Ambient-Node/Ambient-Node-HW/before-soldering(plan).JPG

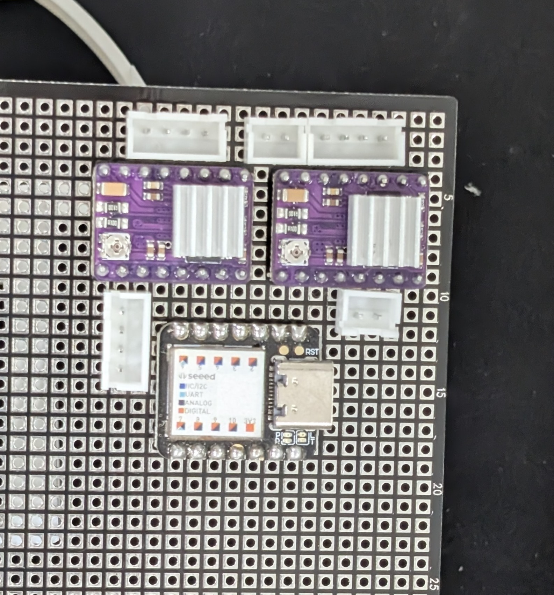
before-soldering(plan).JPG
