Ambient-Node/Ambient-Node-HW/media/soldering-plan.jpg

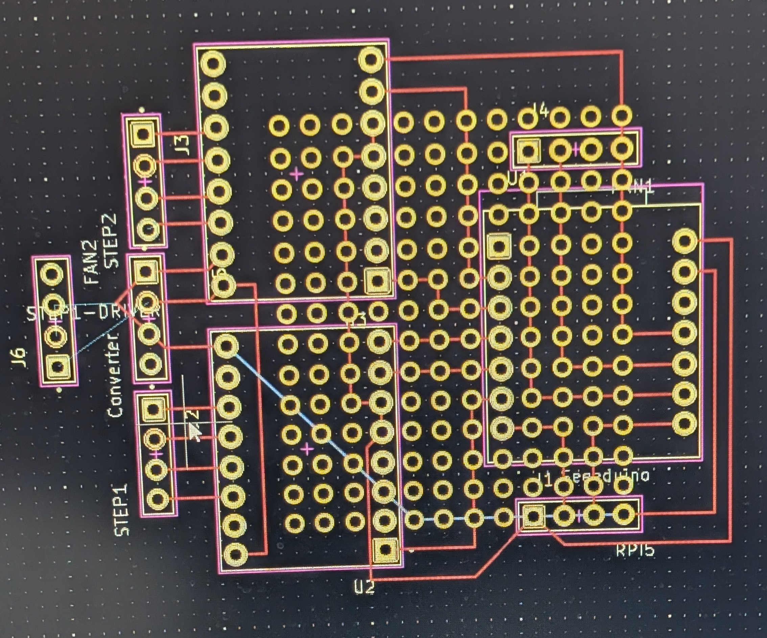
media/soldering-plan.jpg
