Ambient-Node/Ambient-Node-HW/internal-configuration.png

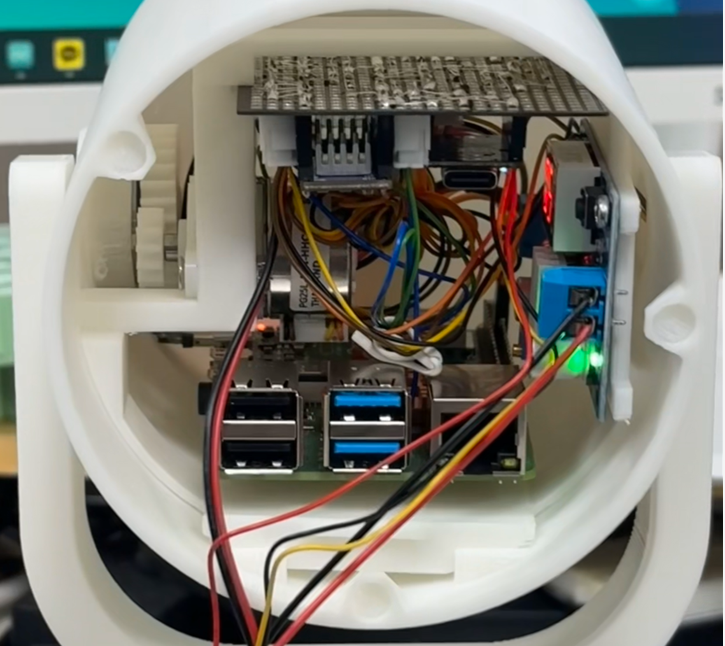
internal-configuration.png
