Ambient-Node/Ambient-Node-HW/media/after-soldering.jpg

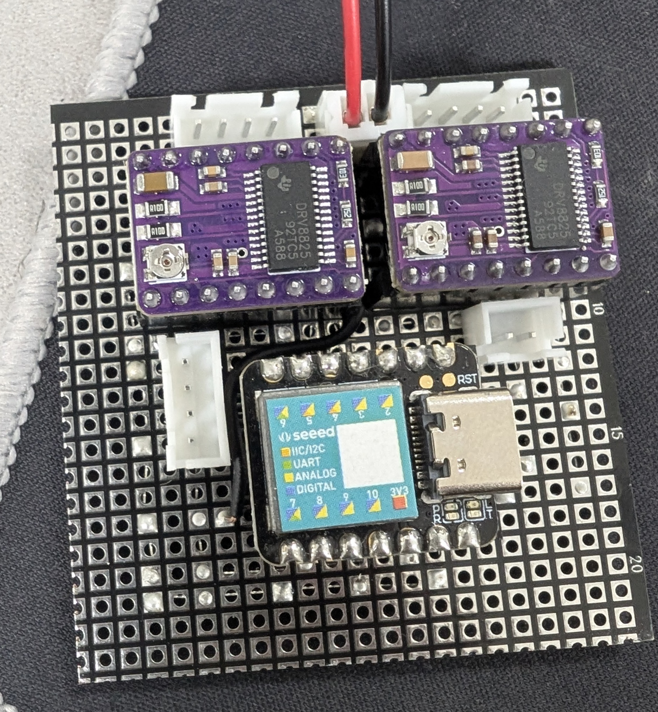
media/after-soldering.jpg
