Ambient-Node/Ambient-Node-HW/codes/PI_test_code/motor_data.csv

Time_ms | Target_Pos | Current_Pos
884507 | -379 | -397
884517 | -379 | -394
884527 | -379 | -394
884537 | -379 | -394
884547 | -379 | -394
884557 | -379 | -394
884567 | -379 | -394
884577 | -379 | -394
884587 | -379 | -394
884597 | -379 | -394
884607 | -379 | -394
884617 | -379 | -394
884627 | -379 | -394
884637 | -379 | -394
884647 | -379 | -394
884657 | -379 | -394
884667 | -379 | -394
884677 | -375 | -391
884687 | -375 | -390
884697 | -375 | -390
884707 | -375 | -390
884717 | -375 | -390
884727 | -375 | -390
884737 | -375 | -390
884747 | -375 | -390
884757 | -375 | -390
884767 | -375 | -390
884777 | -375 | -390
884787 | -375 | -390
884797 | -375 | -390
884807 | -375 | -390
884817 | -375 | -390
884827 | -375 | -390
884837 | -375 | -390
884847 | -375 | -390
884857 | -375 | -390
884867 | -375 | -390
884877 | -375 | -390
884887 | -375 | -390
884897 | -375 | -390
884907 | -375 | -390
884917 | -375 | -390
884927 | -375 | -390
884937 | -375 | -390
884947 | -375 | -390
884957 | -375 | -390
884967 | -375 | -390
884977 | -375 | -390
884987 | -375 | -390
884997 | -375 | -390
885007 | -375 | -390
885017 | -375 | -390
885027 | -375 | -390
885037 | -375 | -390
885047 | -375 | -390
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
