Ambient-Node/Ambient-Node-HW/codes/PI_test_code/tracking_result.png

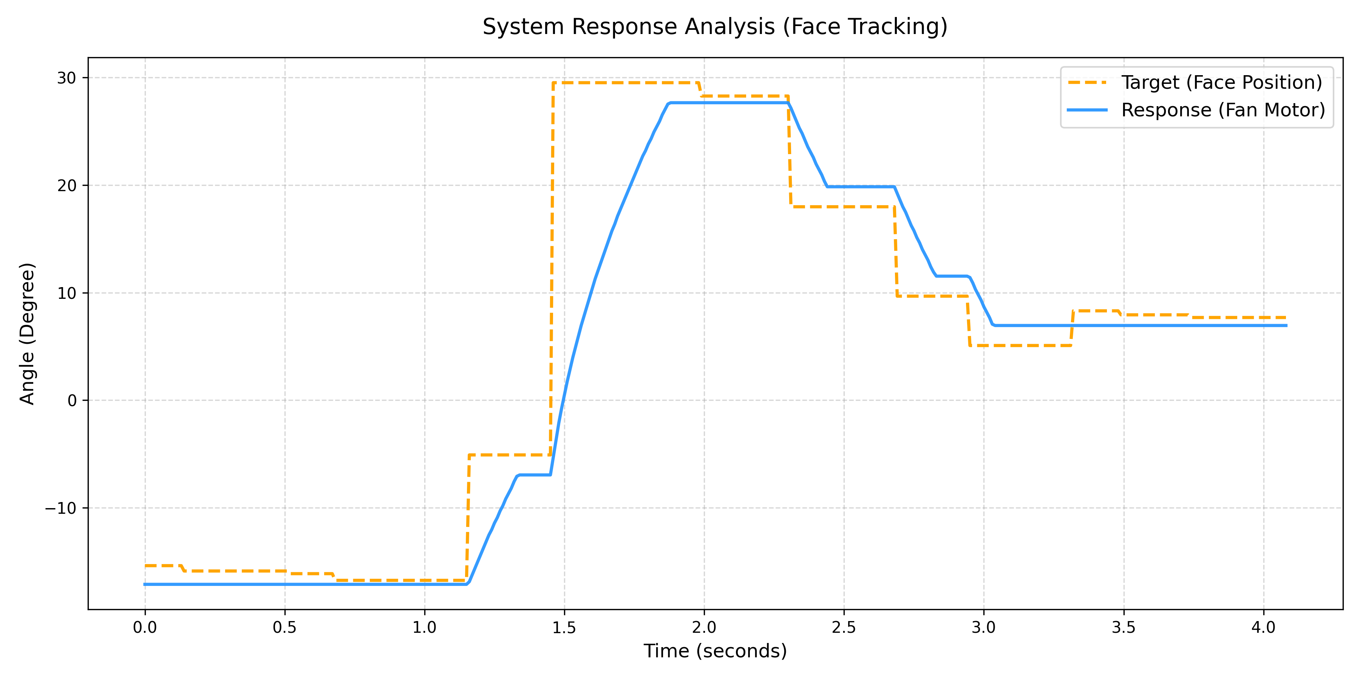
codes/PI_test_code/tracking_result.png
