Ambient-Node/Ambient-Node-HW/codes/PI_test_code/tracking_result_20251128_033356.png

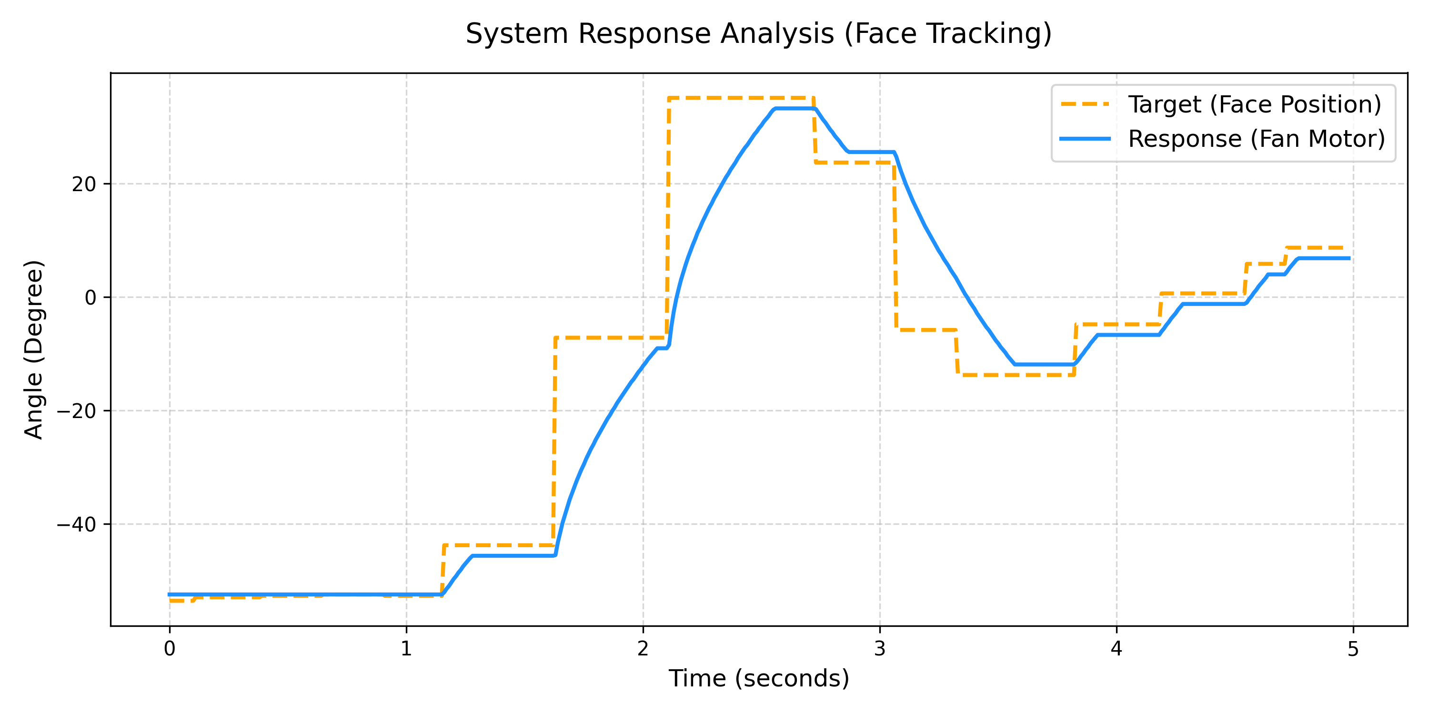
codes/PI_test_code/tracking_result_20251128_033356.png
